roshan151/Robot-RPi-Core/docs/images/Motor-L298.png

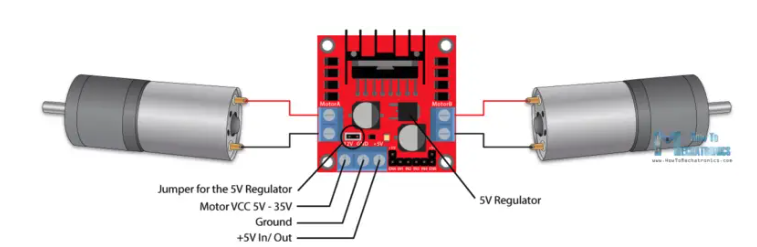
docs/images/Motor-L298.png
