roshan151/Robot-RPi-Core/docs/images/Arduino.png

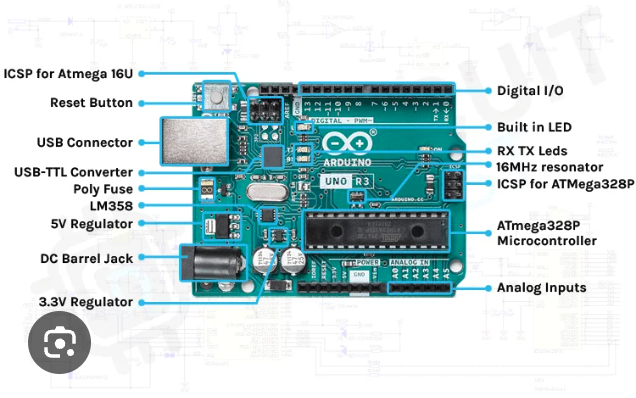
docs/images/Arduino.png
