roshan151/Robot-RPi-Core/docs/images/L298.png

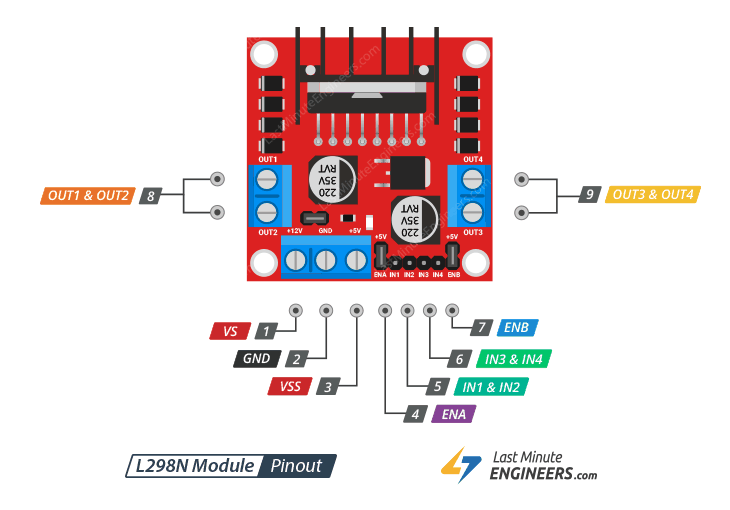
docs/images/L298.png
