roshan151/Robot-RPi-Core/docs/images/Motor-Encoder.png

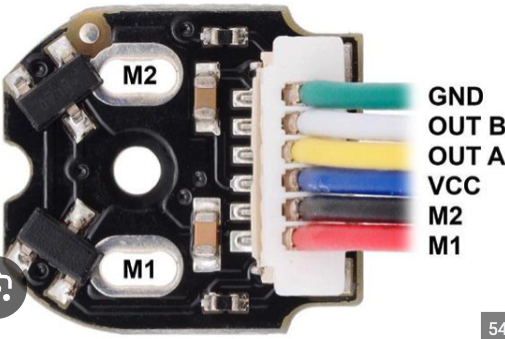
docs/images/Motor-Encoder.png
