roshan151/Robot-RPi-Core/docs/images/Raspberry-PI.png

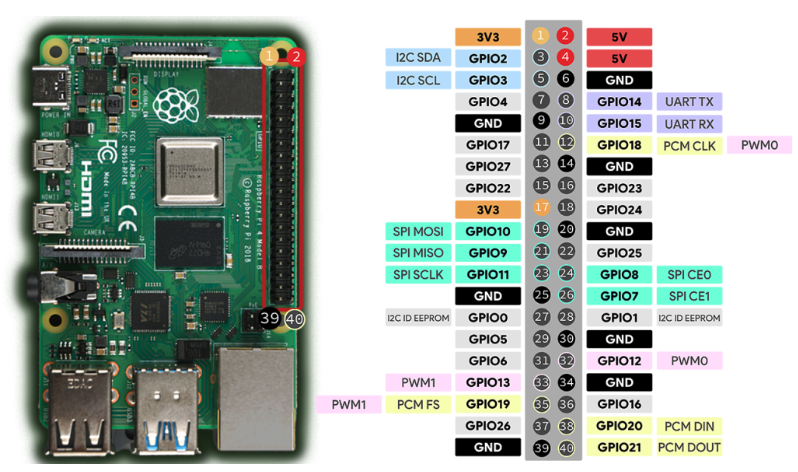
docs/images/Raspberry-PI.png
