roshan151/Robot-RPi-Core/docs/images/Screenshot 2026-04-29 at 7.11.43 PM.png

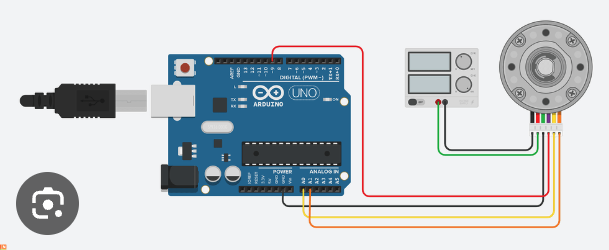
docs/images/Screenshot 2026-04-29 at 7.11.43 PM.png
