roshan151/Robot-RPi-Core/fov.jpg

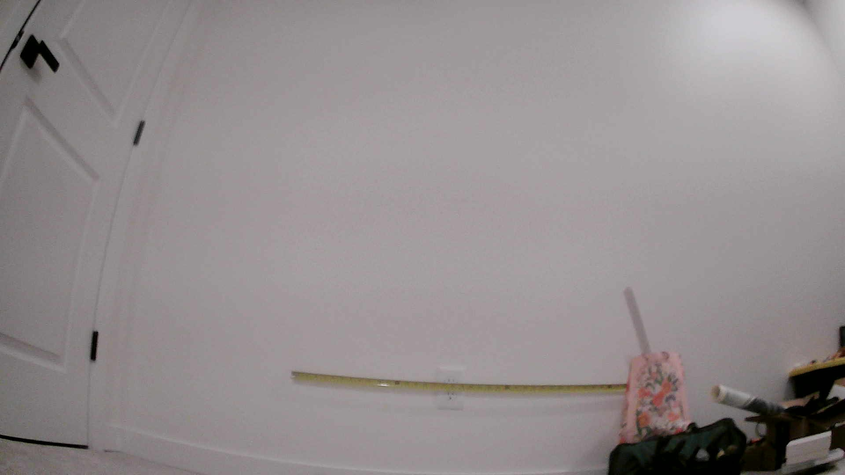
fov.jpg
