roshan151/Robot-RPi-Core/docs/images/wiring_star_ground_fixed.png

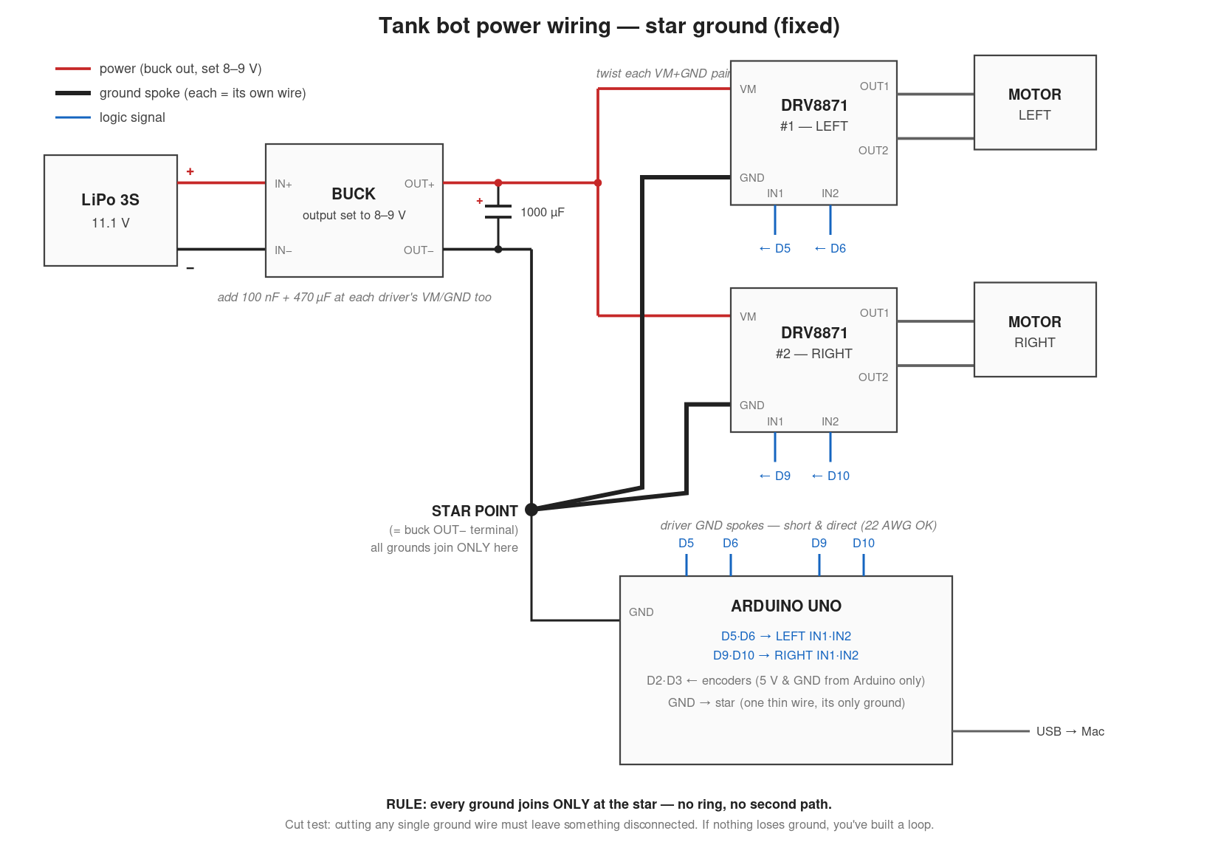
docs/images/wiring_star_ground_fixed.png
