roshan151/Robot-RPi-Core/(commit log)

2026-09-30 slam-v1 ready
    [robot.yaml]
2026-09-30 persistent saving on mac
    [robot.yaml]
2026-09-30 fixed ticks per degree
    [robot.yaml]
2026-10-01 robot look
    [robot.yaml]
2026-10-01 debug servo
2026-10-02 new tests for gimbal
    [robot.yaml]
2026-10-05 gimbal fix
    [robot.yaml]
2026-10-05 debug explopre mode
    [robot.yaml]
2026-10-05 camera recovery
2026-10-06 debug camera
2026-10-06 tools to pan
    [robot.yaml]
2026-10-06 gimbal stability
    [robot.yaml]
2026-10-08 gpio gimbal check
    [robot.yaml]
2026-10-08 turn calibration
    [robot.yaml]
2026-10-09 OLED: error box, battery icon, eyes and tank animations
    Errors show in a small-print box and expire after 20 s; the battery
    percentage becomes an icon; free space plays an animation (blinking eyes,
    tank while the drivetrain runs a move).
    Claude-Session: https://claude.ai/code/session_0174to4X2AyMFLsxVU9cNSeA
    [check_oled.py, oled.py, status.py]
2026-10-09 OLED: small header, icon-only battery, face outline, box robot
    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
2026-10-13 test wheel malfunction
2026-10-13 debug wheels response
2026-10-13 switched left motor drv to pwm 11
2026-11-03 servo power check gpio change
2026-11-04 upgrade to UNC camera and fallback mic
2026-11-11 calibrating camera
2026-11-11 camera bootup and fov calibration
